masha256/opengarden/opengarden_remote_v1.png

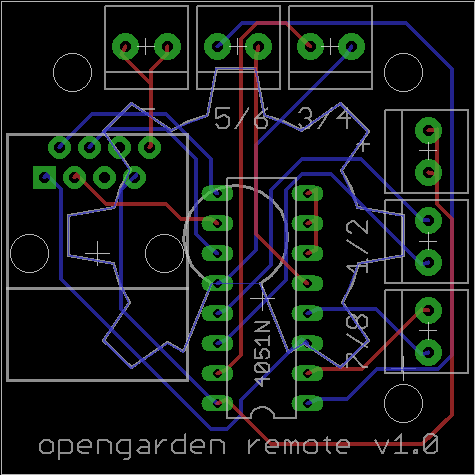
opengarden_remote_v1.png
