masha256/opengarden/opengarden_remote_v1_schematic.png

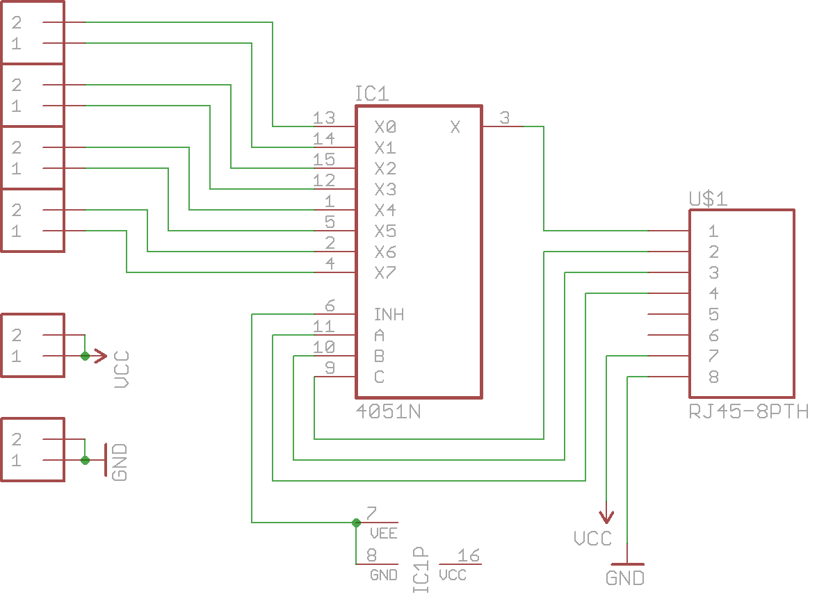
opengarden_remote_v1_schematic.png
