masha256/opengarden/opengarden_v1.png

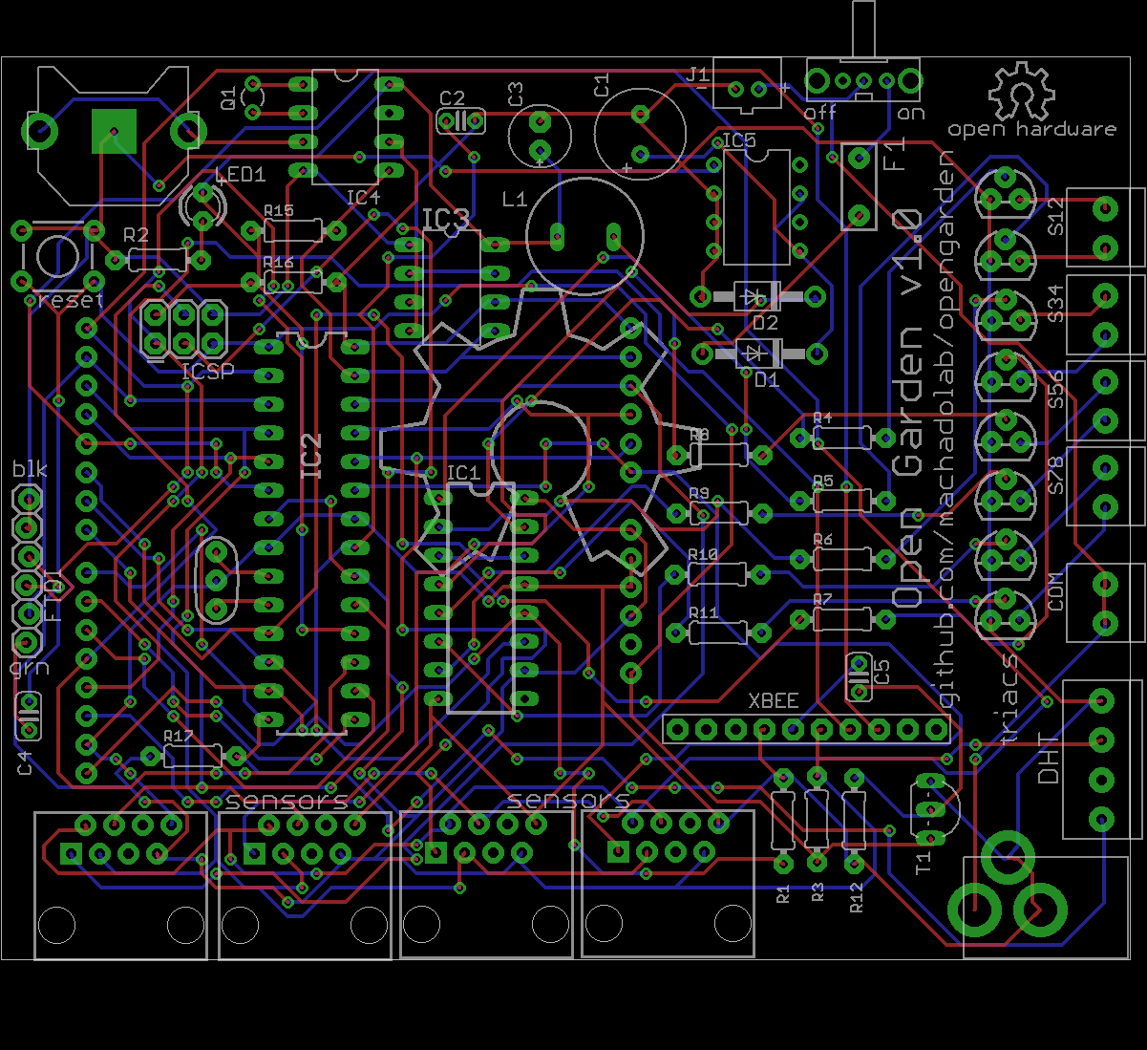
opengarden_v1.png
