masha256/opengarden/opengarden_v1_schematic.png

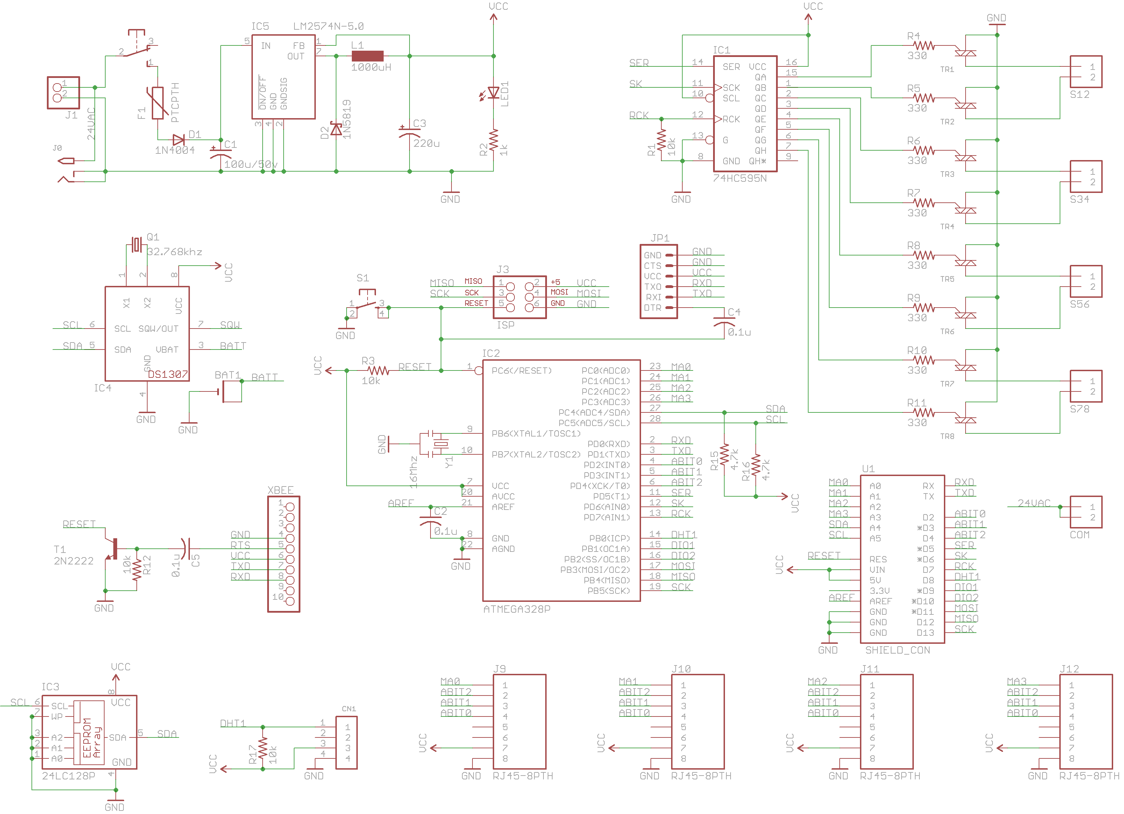
opengarden_v1_schematic.png
