masha256/opengarden/opengarden_v1.brd

## EAGLE design opengarden_v1.brd (2012-05-13)

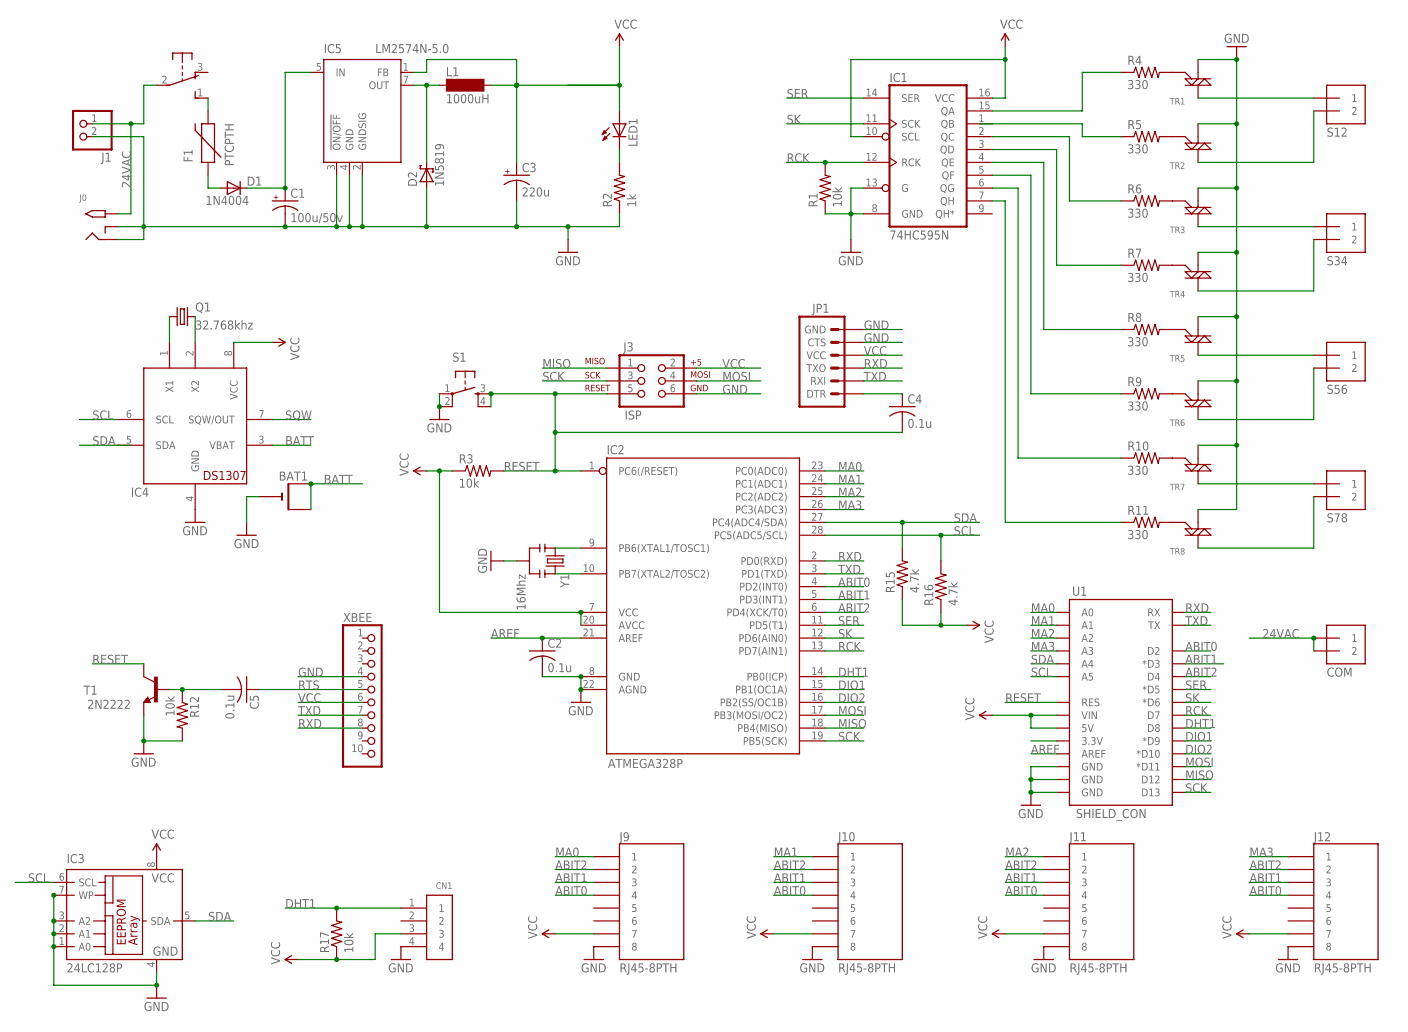
[picture p5: schematic opengarden_v1.sch]

Parts:
BAT1: CR1220THM; CR1220-THM
C1: 100u/50v; E3,5-8
C2, C4, C5: 0.1u; C025-024X044
C3: 220u; E2,5-6E
CN1: 1X4-3.5MM; 1X04-3.5MM
COM: 1X2-3.5MM
D1: 1N4004; DO41-10
D2: 1N5819; DO41-10
F1: PTCPTH; PTC
IC1: 74HC595N; DIL16
IC2: ATMEGA328P; DIL28-3
IC3: 24LC128P; DIL8
IC4: DS1307; DIL08
IC5: LM2574N-5.0; DIL08
J0: 2.1MMJACKTHM; PJ-102A
J1: JST_2PIN-THM; JST-PH-2-THM
J2: OS102011MA1Q
J3: ISP; 2X3
J9, J10, J11, J12: RJ45-8PTH; RJ45-8
JP1: ARDUINO_SERIAL_PROGRAMLOCK; 1X06_LOCK
L1: 1000uH; BS11
LED1: LED3MM
Q1: 32.768khz; TC26V
R1, R3, R12, R17: 10k; 0204/7
R2: 1k; 0204/7
R4, R5, R6, R7, R8, R9, R10, R11: 330; 0204/7
R15, R16: 4.7k; 0204/7
S1: TAC_SWITCHPTH; TACTILE-PTH
S12, S34, S56, S78: 1X2-3.5MM
T1: 2N2222; TO92-EBC-OVAL
TR1, TR2, TR3, TR4, TR5, TR6, TR7, TR8: TRIACPTH; TO-92
U1: SHIELD_CON; DUEMILANOVE_VIAS
XBEE: XBEE; 1X10-BIG
Y1: 16Mhz; RESONATOR-PTH

Connections:
24VAC: COM.1, COM.2, J0.TIP, J1.1 (2), J2.2
ABIT0: IC2.4 (PD2(INT0)), J9.4, J10.4, J11.4, J12.4, U1.D2
ABIT1: IC2.5 (PD3(INT1)), J9.3, J10.3, J11.3, J12.3, U1.D3 (*D3)
ABIT2: IC2.6 (PD4(XCK/T0)), J9.2, J10.2, J11.2, J12.2, U1.D4
AREF: C2.1, IC2.21 (AREF), U1.AREF
BATT: BAT1.+1 (+), BAT1.+2 (+1), IC4.3 (VBAT)
DHT1: CN1.1, IC2.14 (PB0(ICP)), R17.2, U1.D8
DIO1: IC2.15 (PB1(OC1A)), U1.D9 (*D9)
DIO2: IC2.16 (PB2(SS/OC1B)), U1.D10 (*D10)
GND: BAT1.-, C1.-, C2.2, C3.-, CN1.4, D2.A, IC1.8 (GND), IC1.13 (G), IC2.8 (GND), IC2.22 (AGND), IC3.1 (A0), IC3.2 (A1), IC3.3 (A2), IC3.4 (GND), IC3.7 (WP), IC4.4 (GND), IC5.2 (GNDSIG), IC5.3 (!ON/OFF), IC5.4 (GND), J0.RING, J0.RING_SW, J1.2 (1), J3.6, J9.8, J10.8, J11.8, J12.8, JP1.5 (CTS), JP1.6 (GND), R1.1, R2.1, R12.2, S1.1, S1.2, T1.E, TR1.1 (M1), TR2.1 (M1), TR3.1 (M1), TR4.1 (M1), TR5.1 (M1), TR6.1 (M1), TR7.1 (M1), TR8.1 (M1), U1.GND@0 (GND), U1.GND@1 (GND), U1.GND@2 (GND), XBEE.4, Y1.2
MA0: IC2.23 (PC0(ADC0)), J9.1, U1.A0
MA1: IC2.24 (PC1(ADC1)), J10.1, U1.A1
MA2: IC2.25 (PC2(ADC2)), J11.1, U1.A2
MA3: IC2.26 (PC3(ADC3)), J12.1, U1.A3
MISO: IC2.18 (PB4(MISO)), J3.1, U1.D12
MOSI: IC2.17 (PB3(MOSI/OC2)), J3.4, U1.D11 (*D11)
unnamed: IC4.1 (X1), Q1.1
unnamed: IC4.2 (X2), Q1.2
unnamed: IC2.10 (PB7(XTAL2/TOSC2)), Y1.3
unnamed: IC2.9 (PB6(XTAL1/TOSC1)), Y1.1
unnamed: LED1.K (C), R2.2
unnamed: C5.2, R12.1, T1.B
unnamed: C4.1, JP1.1 (DTR)
unnamed: F1.P$2 (2), J2.1 (S)
unnamed: D1.A, F1.P$1 (1)
unnamed: C1.+, D1.C, IC5.5 (IN)
unnamed: D2.C, IC5.7 (OUT), L1.1
unnamed: R4.2, TR1.2 (G)
unnamed: R5.2, TR2.2 (G)
unnamed: R6.2, TR3.2 (G)
unnamed: R7.2, TR4.2 (G)
unnamed: R8.2, TR5.2 (G)
unnamed: R9.2, TR6.2 (G)
unnamed: R10.2, TR7.2 (G)
unnamed: R11.2, TR8.2 (G)
unnamed: IC1.15 (QA), R4.1
unnamed: IC1.1 (QB), R5.1
unnamed: IC1.2 (QC), R6.1
unnamed: IC1.3 (QD), R7.1
unnamed: IC1.4 (QE), R8.1
unnamed: IC1.5 (QF), R9.1
unnamed: IC1.6 (QG), R10.1
unnamed: IC1.7 (QH), R11.1
unnamed: S12.1, TR1.3 (M2)
unnamed: S34.1, TR3.3 (M2)
unnamed: S56.1, TR5.3 (M2)
unnamed: S78.1, TR7.3 (M2)
unnamed: S78.2, TR8.3 (M2)
unnamed: S56.2, TR6.3 (M2)
unnamed: S34.2, TR4.3 (M2)
unnamed: S12.2, TR2.3 (M2)
RCK: IC1.12 (RCK), IC2.13 (PD7(AIN1)), R1.2, U1.D7
RESET: C4.2, IC2.1 (PC6(/RESET)), J3.5, R3.2, S1.3, S1.4, T1.C, U1.RES
RTS: C5.1, XBEE.5
RXD: IC2.2 (PD0(RXD)), JP1.3 (TXO), U1.RX, XBEE.8
SCK: IC2.19 (PB5(SCK)), J3.3, U1.D13
SCL: IC2.28 (PC5(ADC5/SCL)), IC3.6 (SCL), IC4.6 (SCL), R16.2, U1.A5
SDA: IC2.27 (PC4(ADC4/SDA)), IC3.5 (SDA), IC4.5 (SDA), R15.2, U1.A4
SER: IC1.14 (SER), IC2.11 (PD5(T1)), U1.D5 (*D5)
SK: IC1.11 (SCK), IC2.12 (PD6(AIN0)), U1.D6 (*D6)
SQW: IC4.7 (SQW/OUT)
TXD: IC2.3 (PD1(TXD)), JP1.2 (RXI), U1.TX, XBEE.7
VCC: C3.+, CN1.3, IC1.10 (SCL), IC1.16 (VCC), IC2.7 (VCC), IC2.20 (AVCC), IC3.8 (VCC), IC4.8 (VCC), IC5.1 (FB), J3.2, J9.7, J10.7, J11.7, J12.7, JP1.4 (VCC), L1.2, LED1.A, R3.1, R15.1, R16.1, R17.1, U1.5V, U1.VIN, XBEE.6

Notes on the sheet:
S12
S34
S56
S78
COM

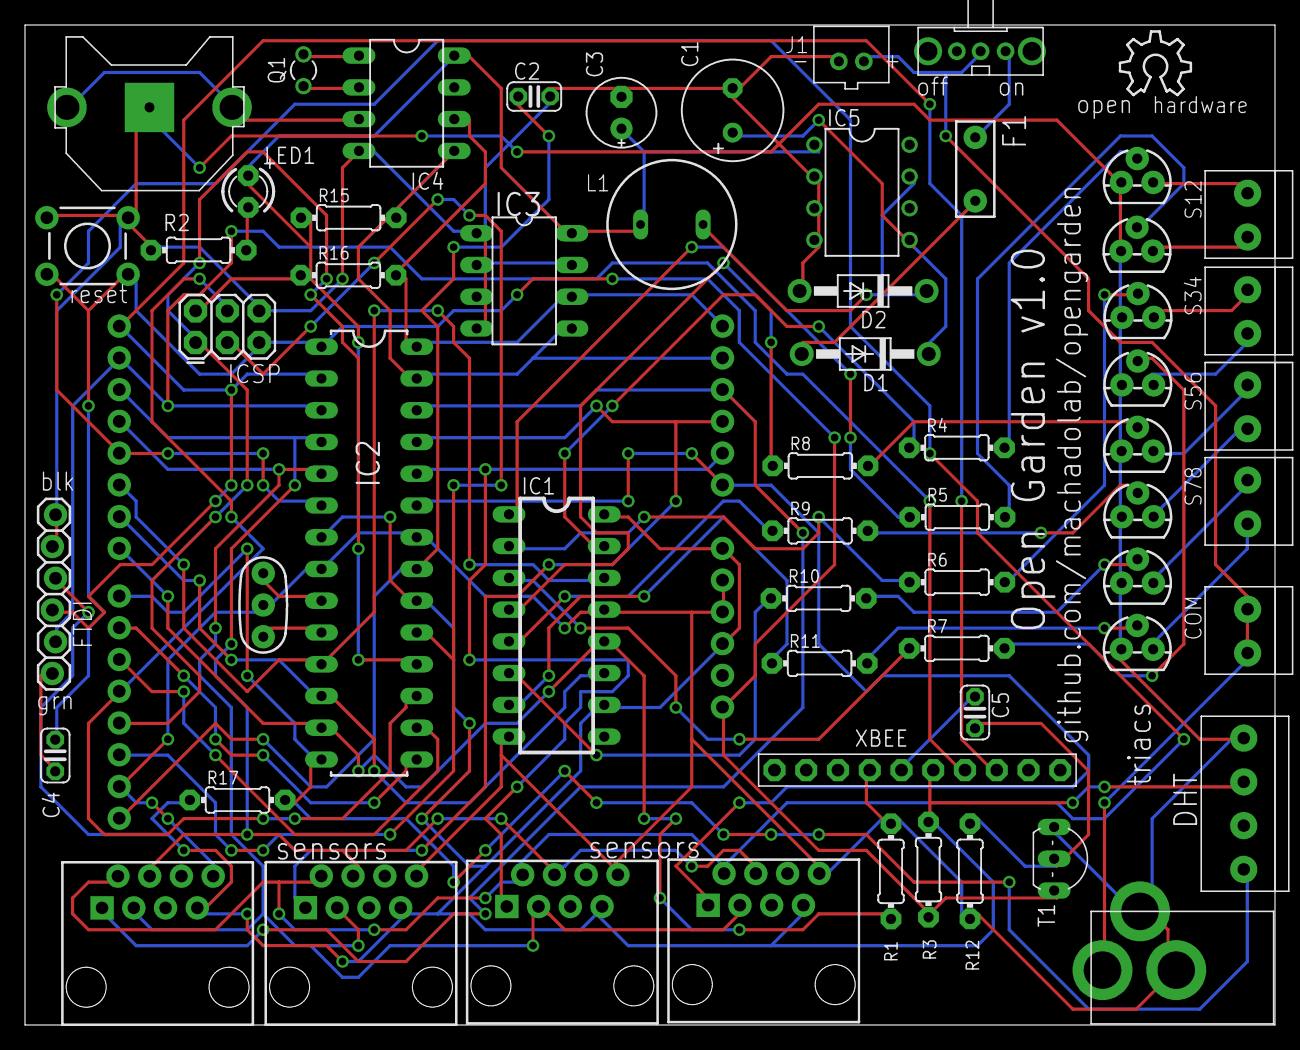
[picture p6: board opengarden_v1.brd from above]

Board: 2 copper layers, 100.0 x 80.0 mm, 62 parts (1 on the bottom side), 62 nets.

Other parts of the board:
U$1: OSHW_10X1000_NOTEXT
U$2: OSHW_8X200_NOTEXT
