masha256/opengarden/opengarden_remote_v1.brd

## EAGLE design opengarden_remote_v1.brd (2012-05-13)

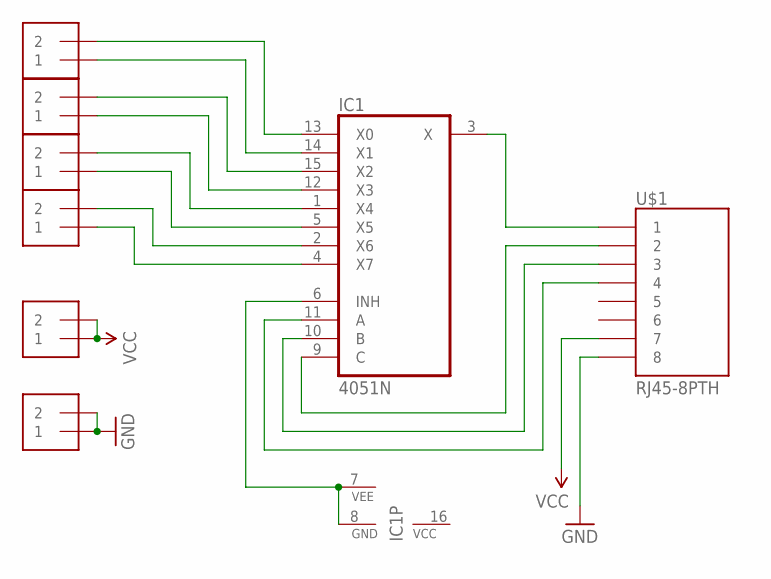
[picture p7: schematic opengarden_remote_v1.sch]

Parts:
IC1: 4051N; DIL16
J1, J2, J3, J4, J9, J10: 1X2-3.5MM
U$1: RJ45-8PTH; RJ45-8

Connections:
GND: J4.1, J4.2, U$1.8
unnamed: IC1.13 (X0), J1.2
unnamed: IC1.14 (X1), J1.1
unnamed: IC1.15 (X2), J2.2
unnamed: IC1.12 (X3), J2.1
unnamed: IC1.1 (X4), J3.2
unnamed: IC1.5 (X5), J3.1
unnamed: IC1.2 (X6), J9.2
unnamed: IC1.4 (X7), J9.1
unnamed: IC1.3 (X), U$1.1
unnamed: IC1.9 (C), U$1.2
unnamed: IC1.10 (B), U$1.3
unnamed: IC1.11 (A), U$1.4
unnamed: IC1.6 (INH), IC1.7 (VEE), IC1.8 (GND)
VCC: IC1.16 (VCC), J10.1, J10.2, U$1.7

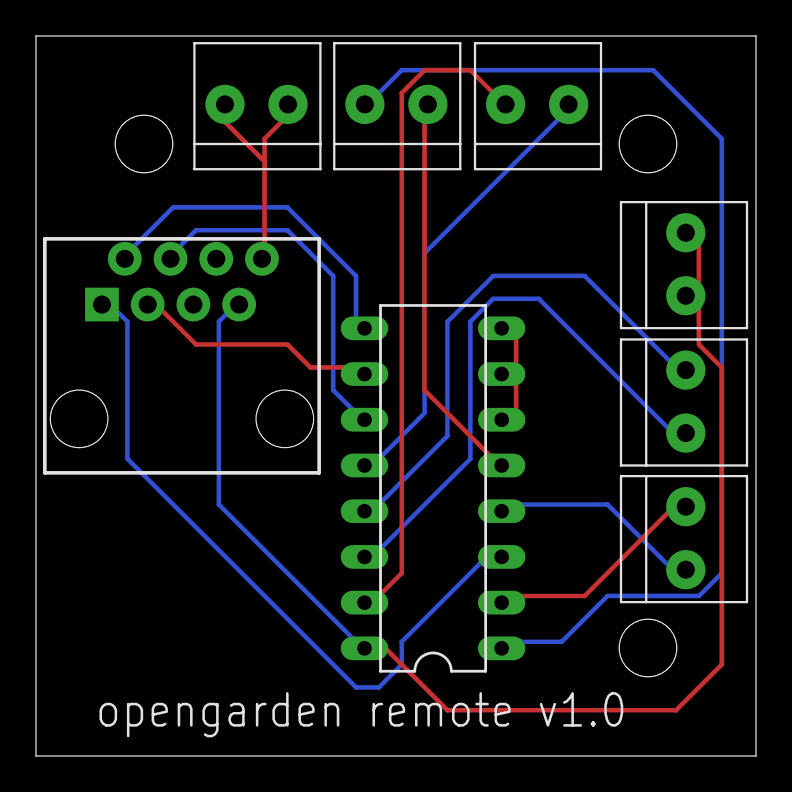
[picture p8: board opengarden_remote_v1.brd from above]

Board: 2 copper layers, 40.0 x 40.0 mm, 9 parts (1 on the bottom side), 15 nets.

Other parts of the board:
U$2: OSHW_8X1000_NOTEXT
